boardburnerclub/LWP_LWD_robot/STL_files/boost_conv_assembly_prnt.3mf

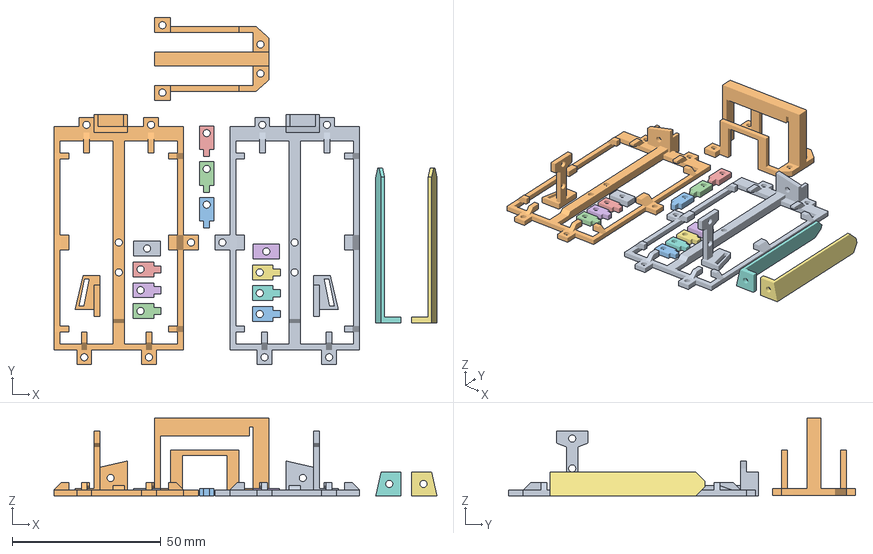
[picture p1: CAD file, 2025-04-11]
STL_files/boost_conv_assembly_prnt.3mf
128.5 x 116.6 x 26.1 mm
boost_conv_holder.stl x 2
boost_conv_holder_back_1.stl x 6
boost_conv_holder_back_2.stl x 3
boost_conv_holder_back_3.stl x 2
boost_conv_slide.stl x 2
boost_conv_slide_rec.stl x 2
BMS_Holder.stl
