boardburnerclub/LWP_LWD_robot/STL_files/LWP_39.stl

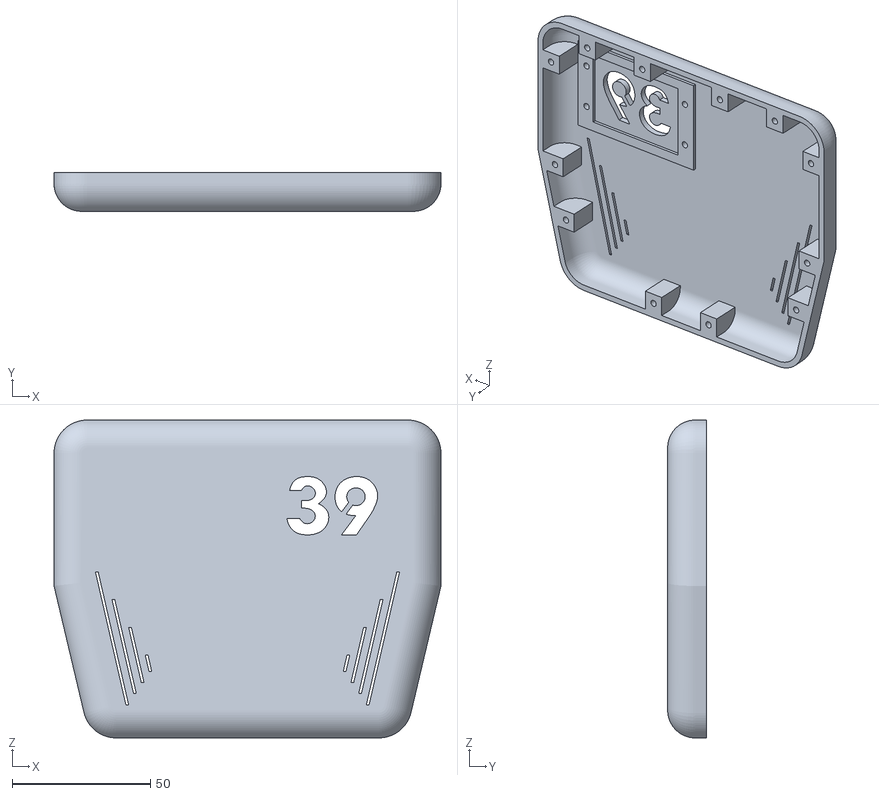
[picture p2: CAD file, 2025-05-03]
STL_files/LWP_39.stl
140.0 x 14.0 x 115.0
