boardburnerclub/LWP_LWD_robot/STL_files/foot_hip_shoulder_neck.3mf

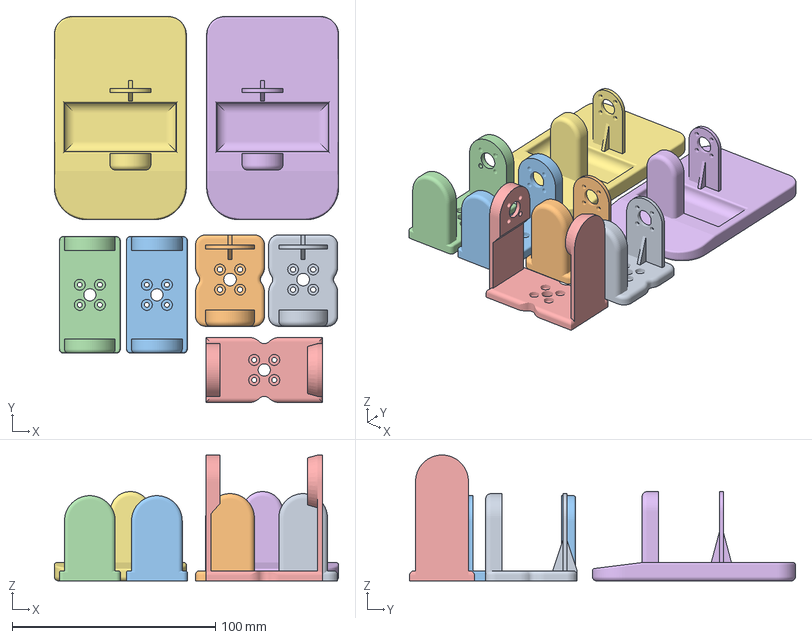
[picture p3: CAD file, 2025-04-19]
STL_files/foot_hip_shoulder_neck.3mf
140.0 x 190.0 x 62.0 mm
left_hip.stl x 2
left_shoulder.stl x 2
neck.stl
left_foot.stl x 2
