boardburnerclub/LWP_LWD_robot/STL_files/left_foot.stl

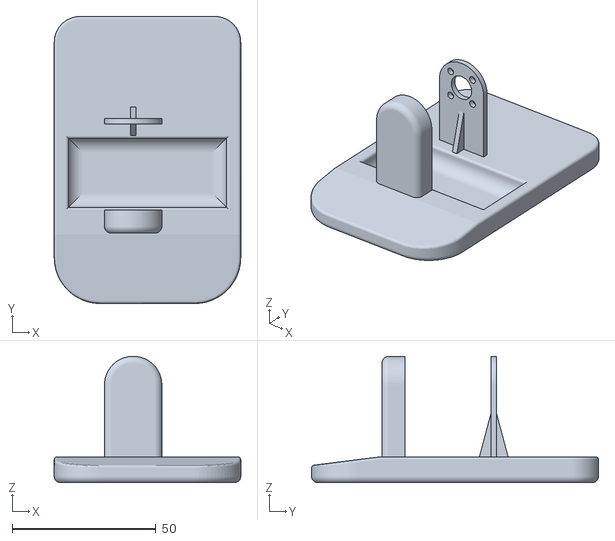
[picture p4: CAD file, 2025-04-19]
STL_files/left_foot.stl
65.0 x 100.0 x 44.0
