boardburnerclub/LWP_LWD_robot/STL_files/lower_leg.stl

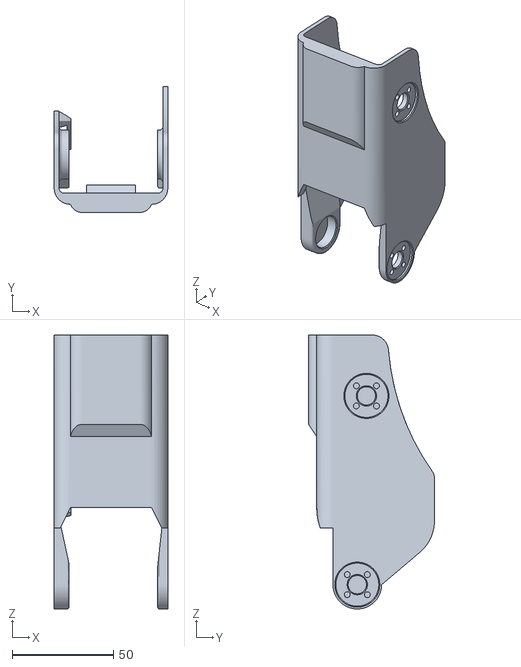
[picture p5: CAD file, 2025-04-12]
STL_files/lower_leg.stl
56.0 x 62.0 x 135.0
