boardburnerclub/LWP_LWD_robot/STL_files/left_upper_leg.stl

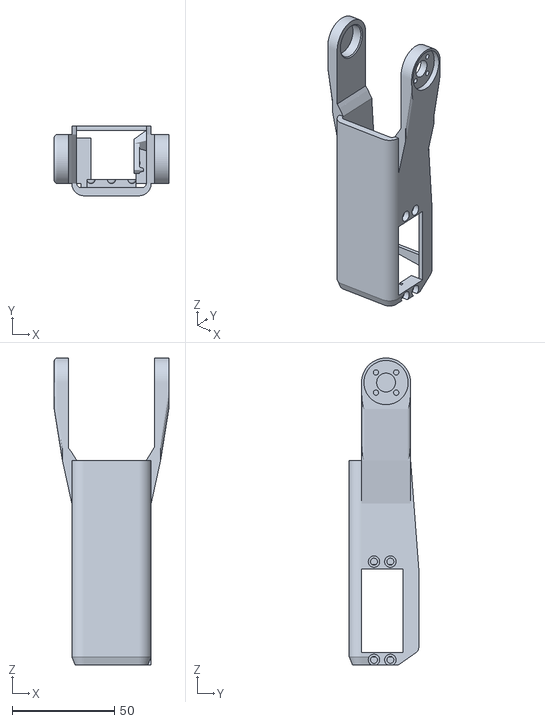
[picture p6: CAD file, 2025-04-12]
STL_files/left_upper_leg.stl
56.0 x 34.0 x 150.0
