boardburnerclub/LWP_LWD_robot/STL_files/legs_prnt.3mf

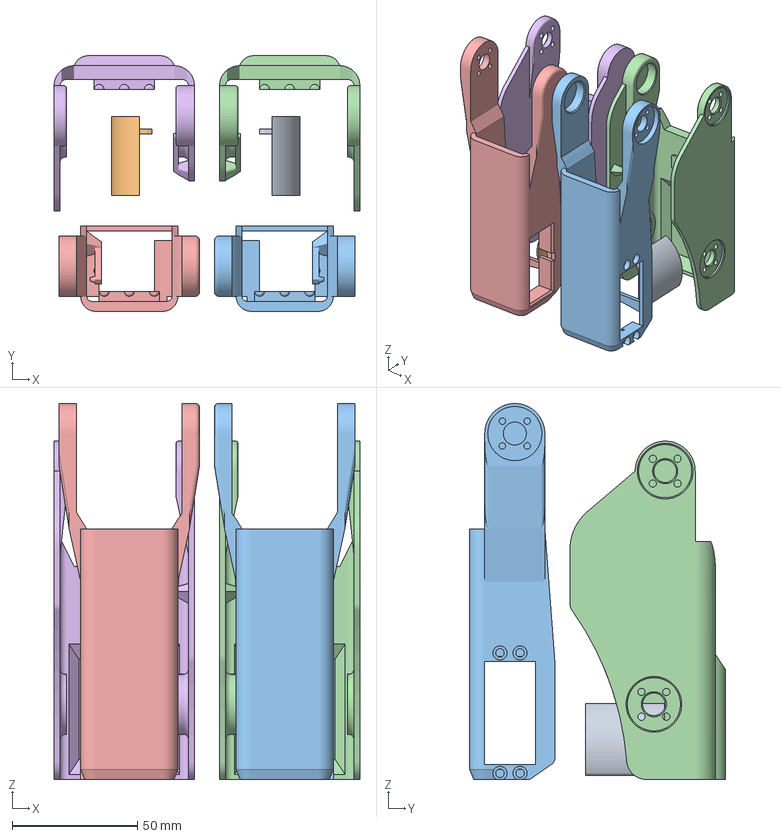
[picture p7: CAD file, 2025-04-12]
STL_files/legs_prnt.3mf
122.0 x 102.0 x 150.0 mm
left_knee_roller.stl x 2
left_upper_leg.stl x 2
lower_leg.stl x 2
