boardburnerclub/LWP_LWD_robot/STL_files/left_knee_roller.stl

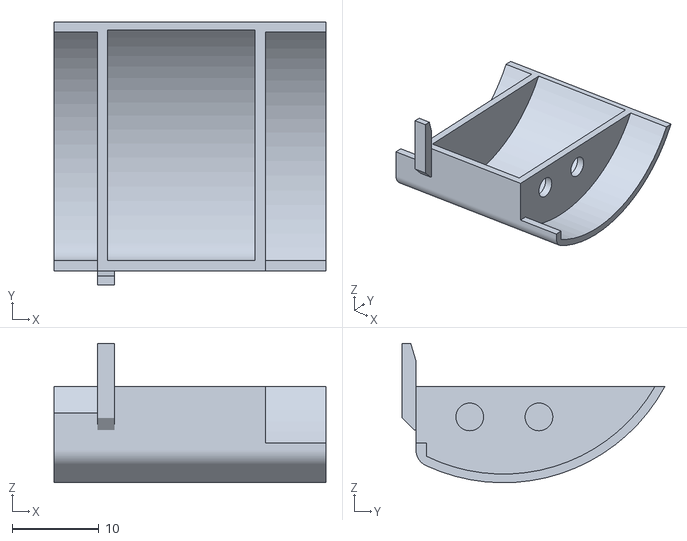
[picture p8: CAD file, 2025-04-11]
STL_files/left_knee_roller.stl
31.4 x 30.3 x 16.1
