boardburnerclub/LWP_LWD_robot/STL_files/head_led_wire_holder_downer.stl

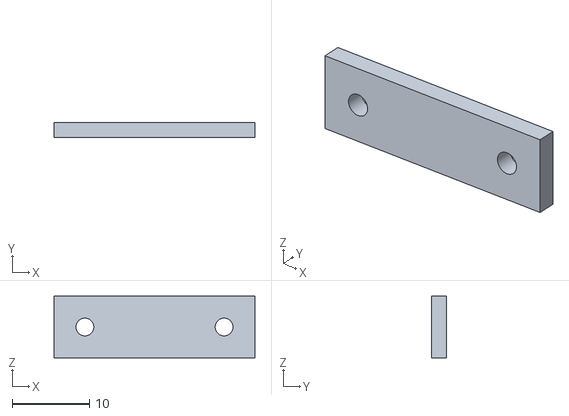
[picture p9: CAD file, 2025-04-11]
STL_files/head_led_wire_holder_downer.stl
26.0 x 2.00 x 8.00
