boardburnerclub/LWP_LWD_robot/STL_files/joint_spacer.stl

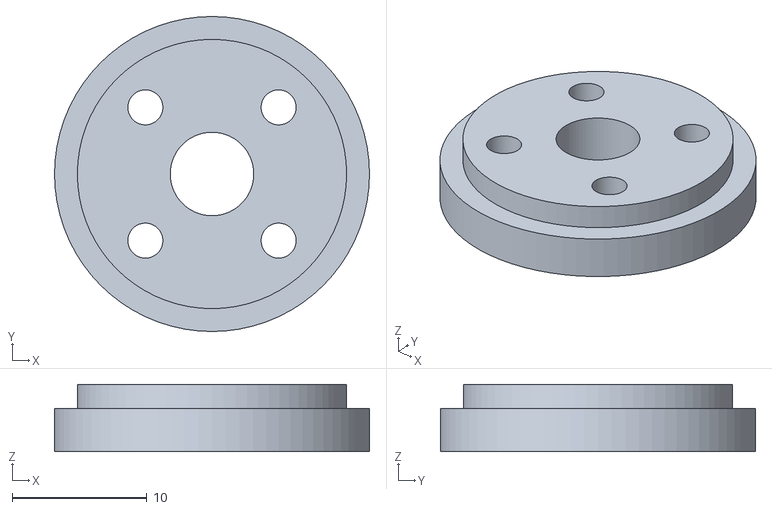
[picture p10: CAD file, 2025-04-11]
STL_files/joint_spacer.stl
23.4 x 23.4 x 5.00
