boardburnerclub/LWP_LWD_robot/STL_files/right_forearm.stl

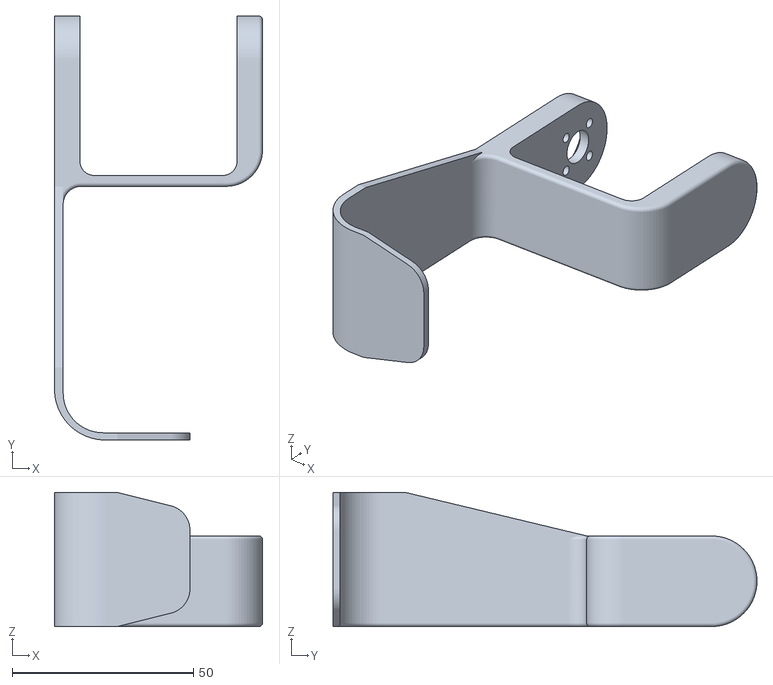
[picture p11: CAD file, 2025-04-11]
STL_files/right_forearm.stl
57.4 x 117.0 x 37.0
