boardburnerclub/LWP_LWD_robot/STL_files/battery_lid_insert.stl

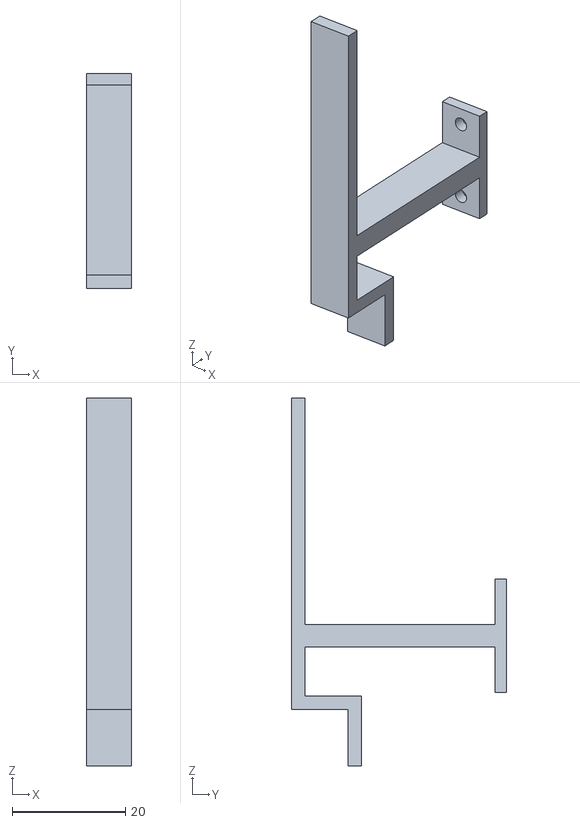
[picture p12: CAD file, 2025-04-11]
STL_files/battery_lid_insert.stl
8.00 x 38.0 x 65.0
