boardburnerclub/LWP_LWD_robot/STL_files/left_shoulder.stl

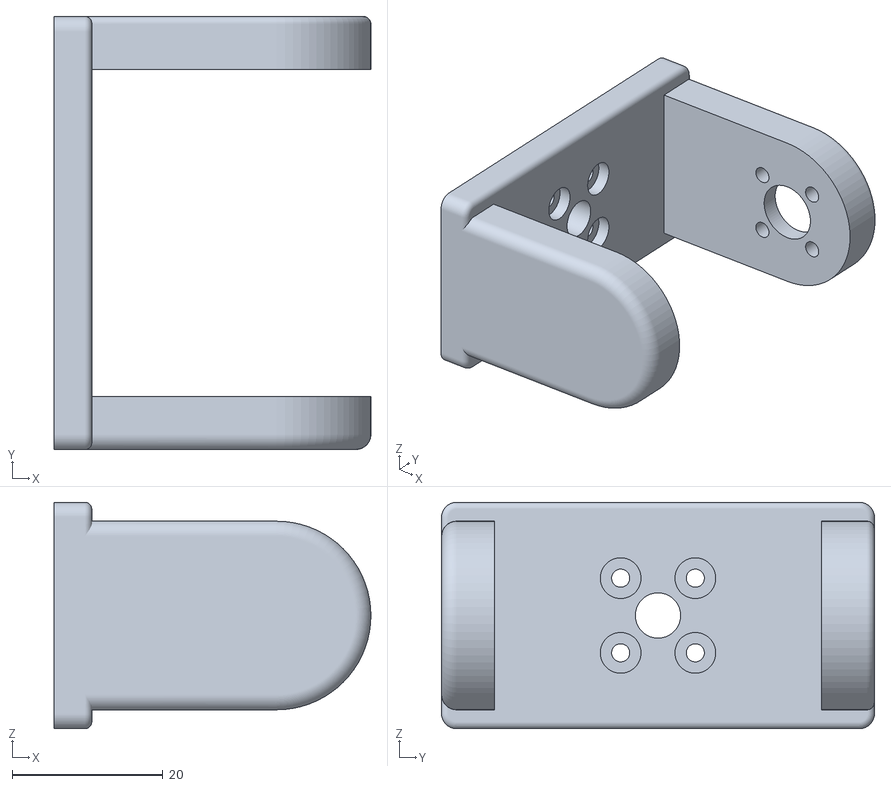
[picture p13: CAD file, 2025-04-11]
STL_files/left_shoulder.stl
42.0 x 57.4 x 30.0
