boardburnerclub/LWP_LWD_robot/STL_files/chest_back.stl

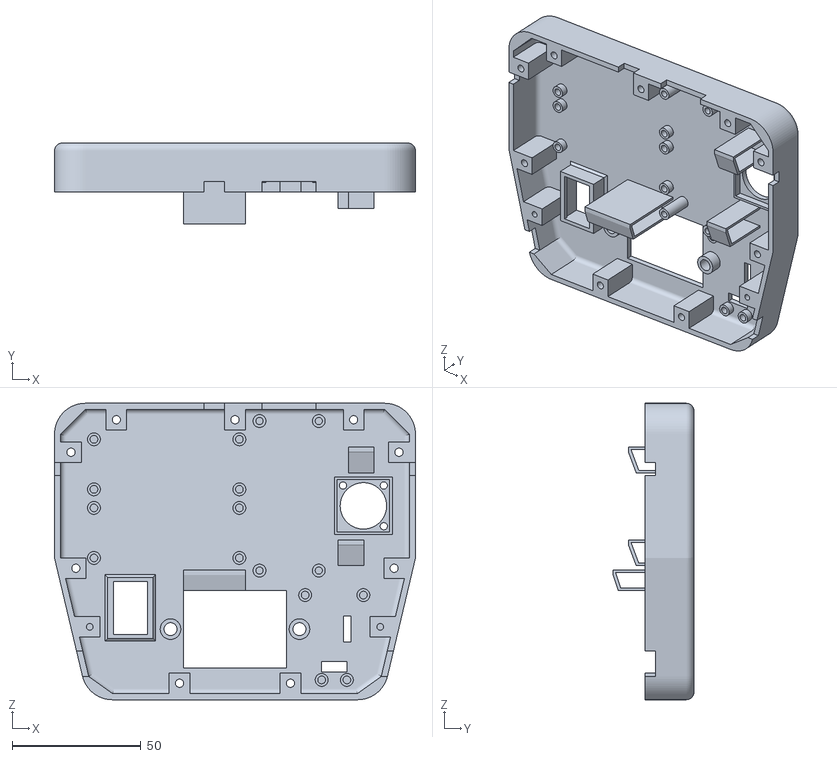
[picture p14: CAD file, 2025-04-11]
STL_files/chest_back.stl
140.0 x 31.4 x 115.0
