boardburnerclub/LWP_LWD_robot/STL_files/Chest_prnt.3mf

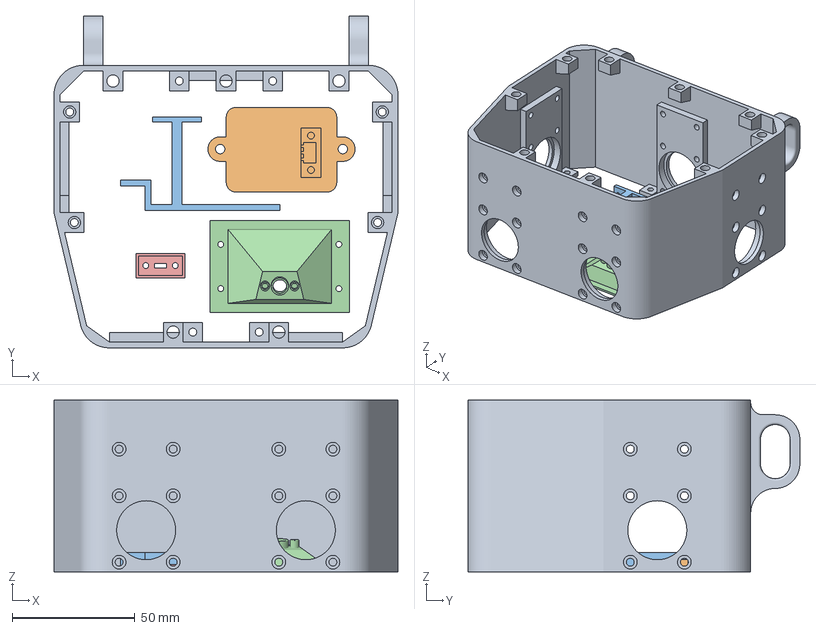
[picture p15: CAD file, 2025-04-11]
STL_files/Chest_prnt.3mf
140.0 x 135.0 x 70.0 mm
Chest.stl
battery_lid.stl
battery_lid_insert.stl
number_plate_holder.stl
number_plate_led_holder_downer.stl
