boardburnerclub/LWP_LWD_robot/STL_files/head_components_prnt.3mf

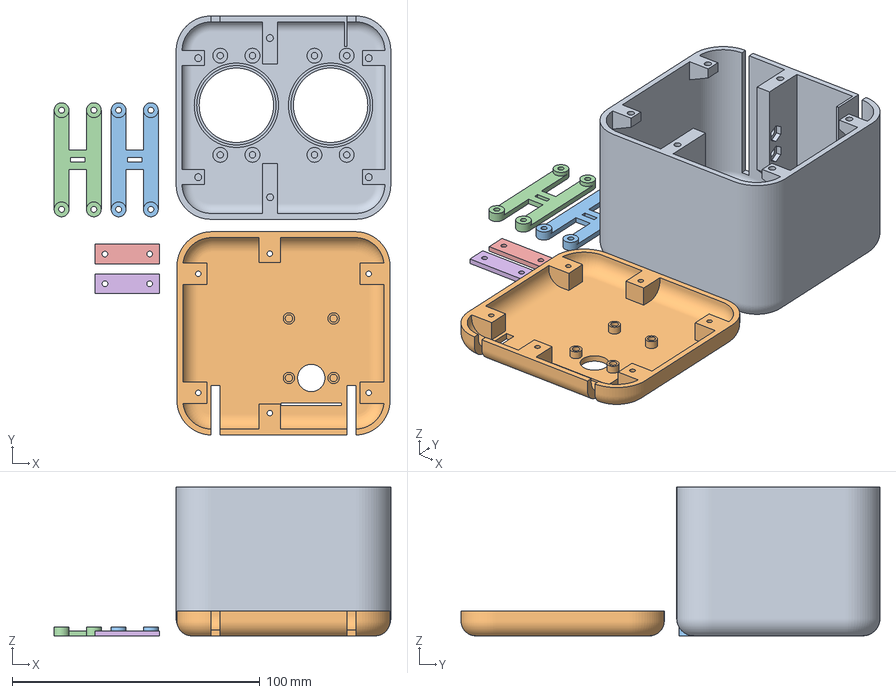
[picture p16: CAD file, 2025-04-11]
STL_files/head_components_prnt.3mf
135.8 x 169.0 x 60.0 mm
head.stl
head_back_cover.stl
eye_LED_holder.stl x 2
head_led_wire_holder_downer.stl x 2
