boardburnerclub/LWP_LWD_robot/STL_files/boost_conv_holder_back_3.stl

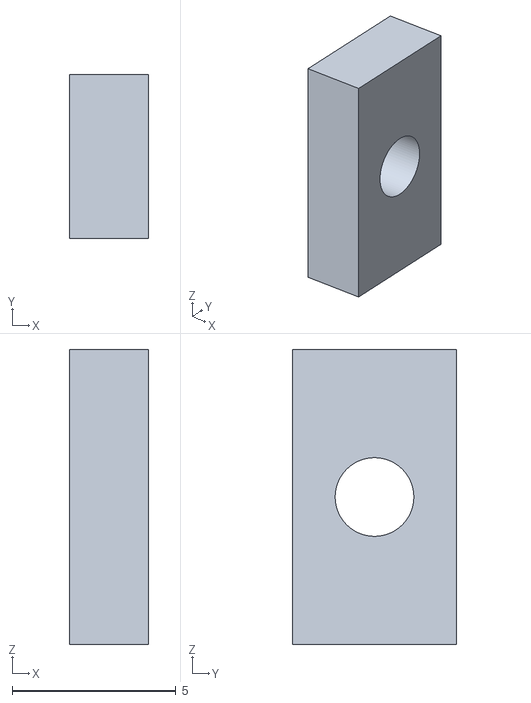
[picture p17: CAD file, 2025-04-11]
STL_files/boost_conv_holder_back_3.stl
2.40 x 5.00 x 9.00
