boardburnerclub/LWP_LWD_robot/STL_files/servo_holder_body.stl

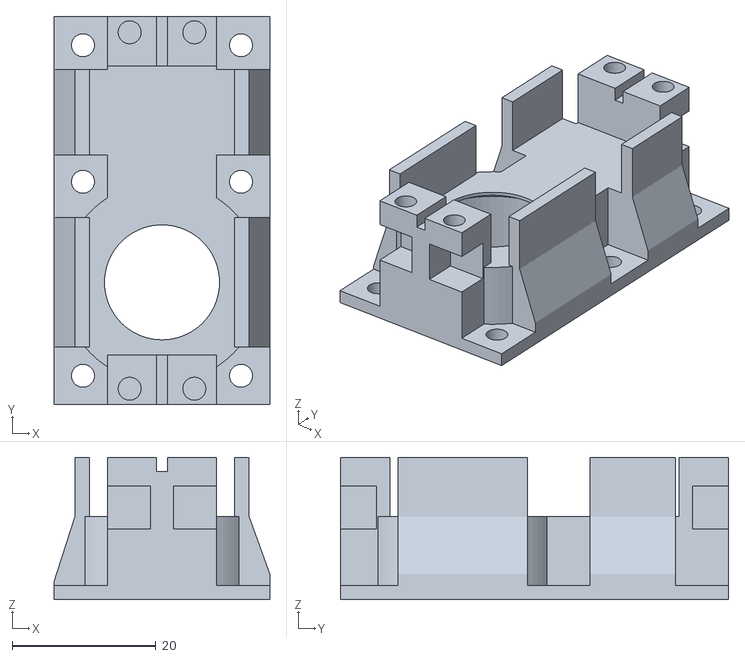
[picture p18: CAD file, 2025-04-11]
STL_files/servo_holder_body.stl
30.0 x 54.0 x 19.8
