boardburnerclub/LWP_LWD_robot/STL_files/number_plate_led_holder_downer.stl

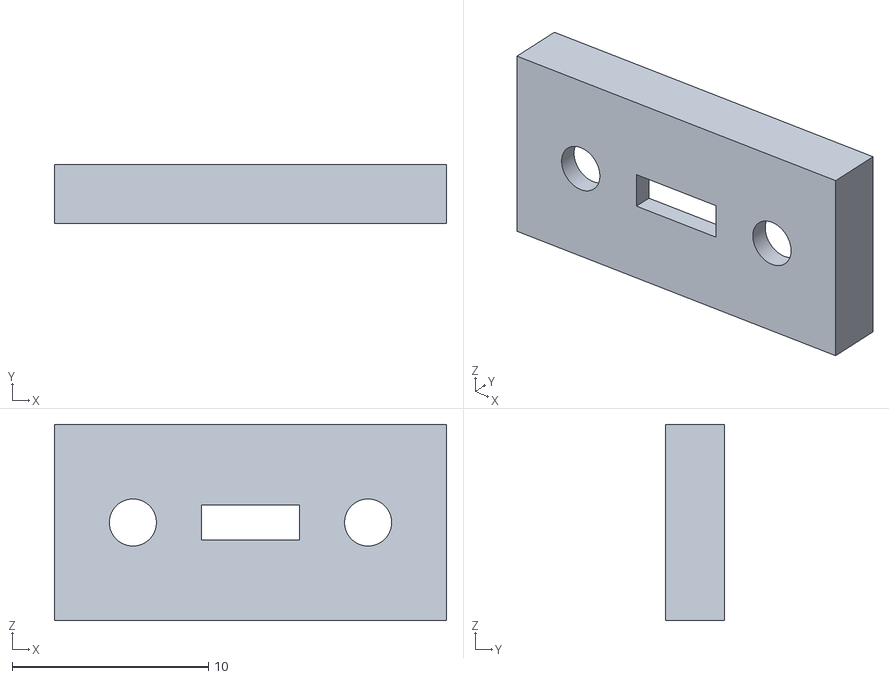
[picture p19: CAD file, 2025-04-11]
STL_files/number_plate_led_holder_downer.stl
20.0 x 3.00 x 10.0
