boardburnerclub/LWP_LWD_robot/STL_files/head.stl

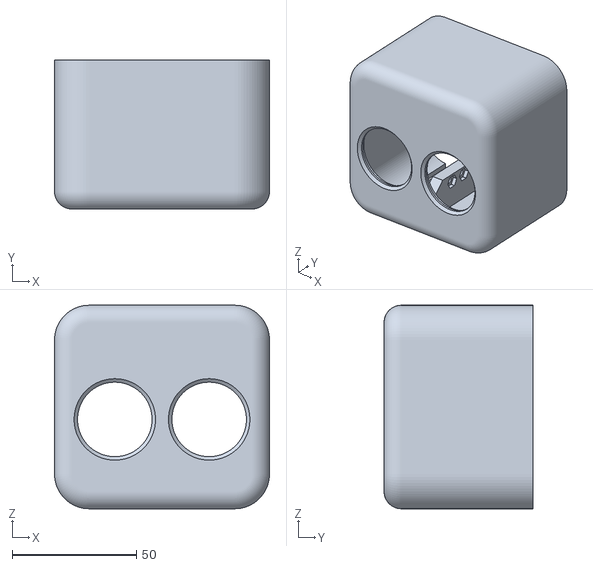
[picture p20: CAD file, 2025-04-11]
STL_files/head.stl
86.6 x 60.0 x 82.0
