boardburnerclub/LWP_LWD_robot/STL_files/iris_number_plate_back_prnt.3mf

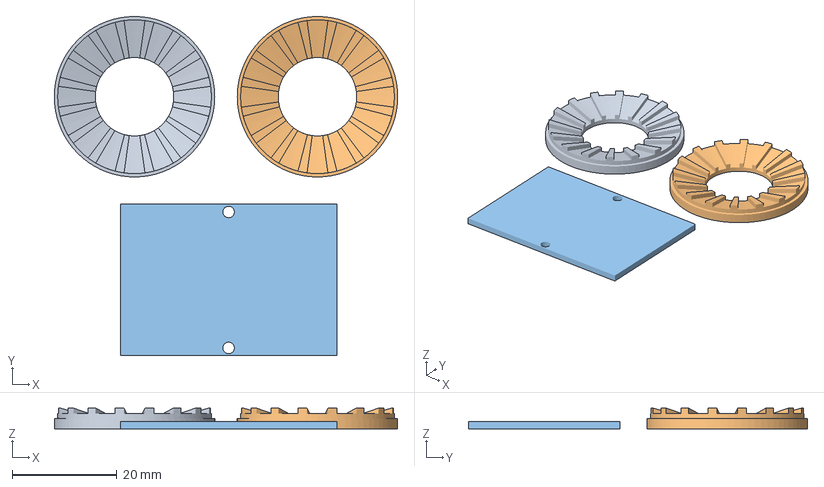
[picture p21: CAD file, 2025-04-11]
STL_files/iris_number_plate_back_prnt.3mf
65.7 x 64.9 x 4.00 mm
iris.stl x 2
chest_number_backing.stl
