boardburnerclub/LWP_LWD_robot/STL_files/boost_conv_holder.stl

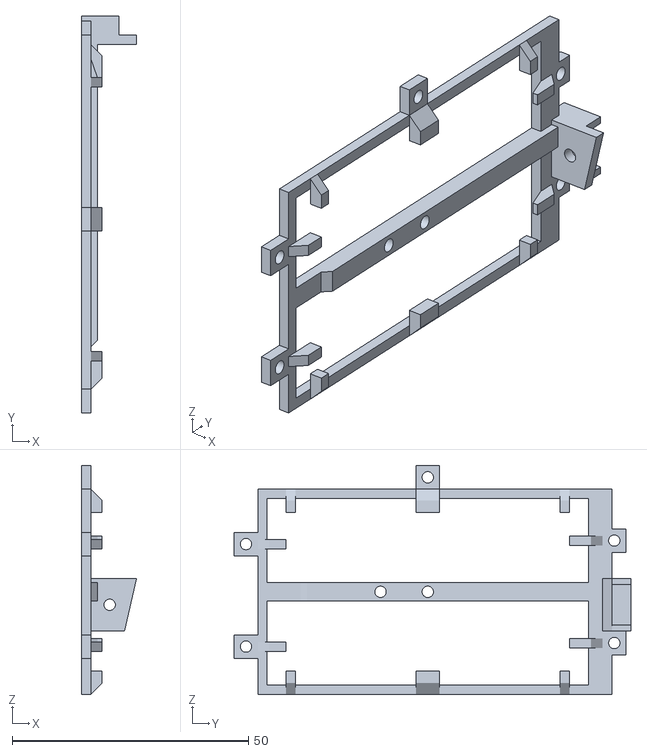
[picture p22: CAD file, 2025-04-11]
STL_files/boost_conv_holder.stl
11.7 x 84.0 x 48.5
