boardburnerclub/LWP_LWD_robot/STL_files/chest_number_backing.stl

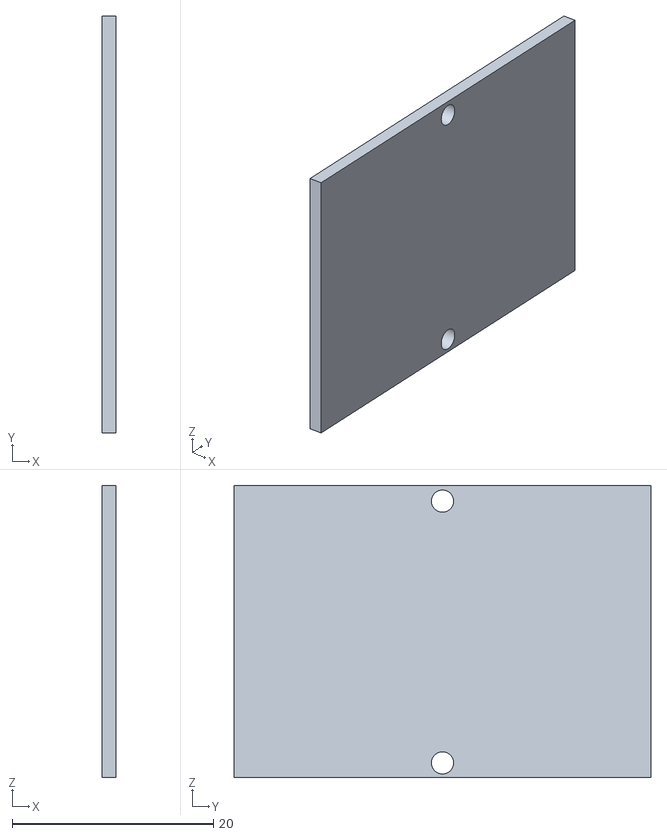
[picture p23: CAD file, 2025-04-11]
STL_files/chest_number_backing.stl
1.40 x 41.4 x 29.0
