boardburnerclub/LWP_LWD_robot/STL_files/left_hip.stl

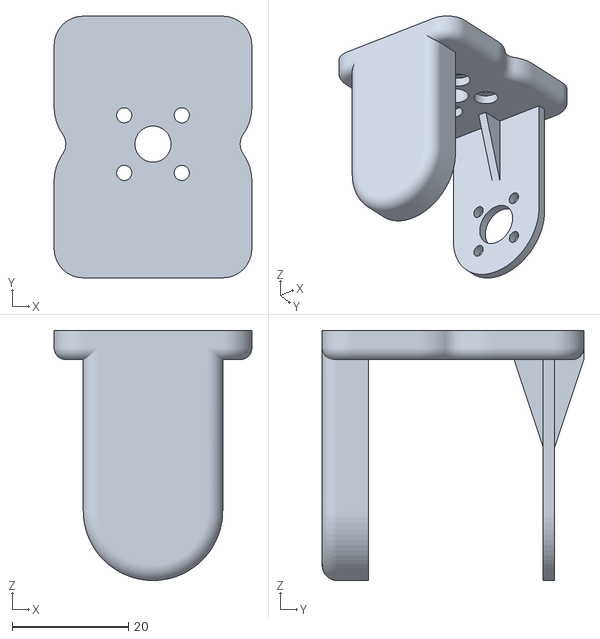
[picture p24: CAD file, 2025-04-11]
STL_files/left_hip.stl
34.0 x 45.0 x 43.0
