boardburnerclub/LWP_LWD_robot/STL_files/servo_back.stl

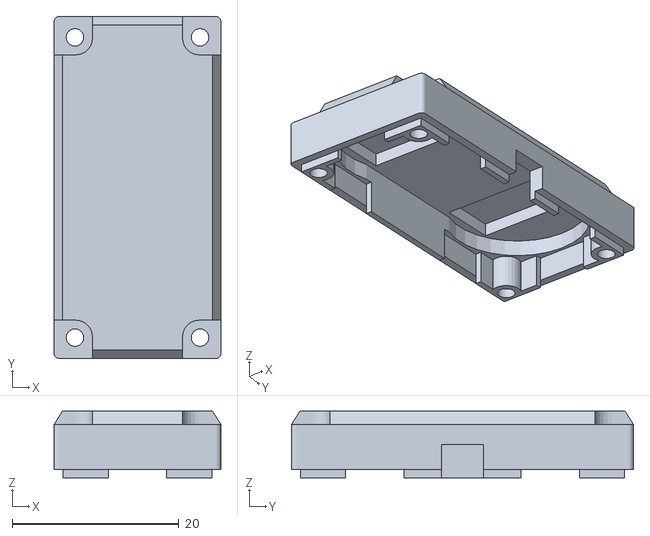
[picture p25: CAD file, 2025-04-11]
STL_files/servo_back.stl
20.0 x 41.0 x 8.00
