boardburnerclub/LWP_LWD_robot/STL_files/BMS_Holder.stl

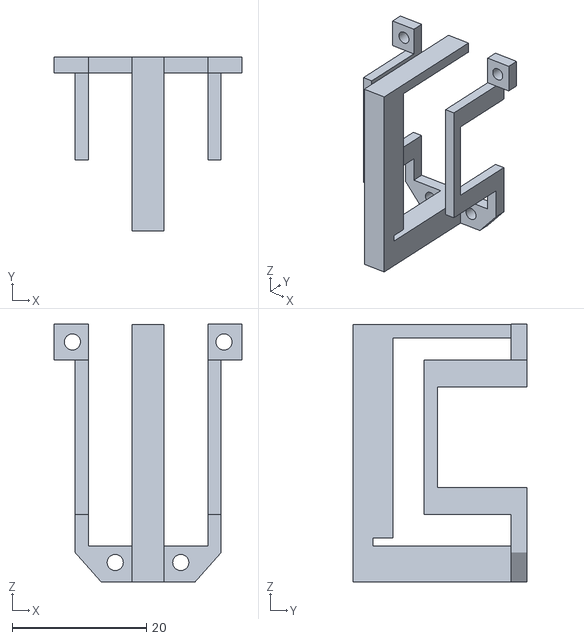
[picture p26: CAD file, 2025-04-11]
STL_files/BMS_Holder.stl
28.0 x 26.0 x 38.5
