boardburnerclub/LWP_LWD_robot/STL_files/eye_LED.stl

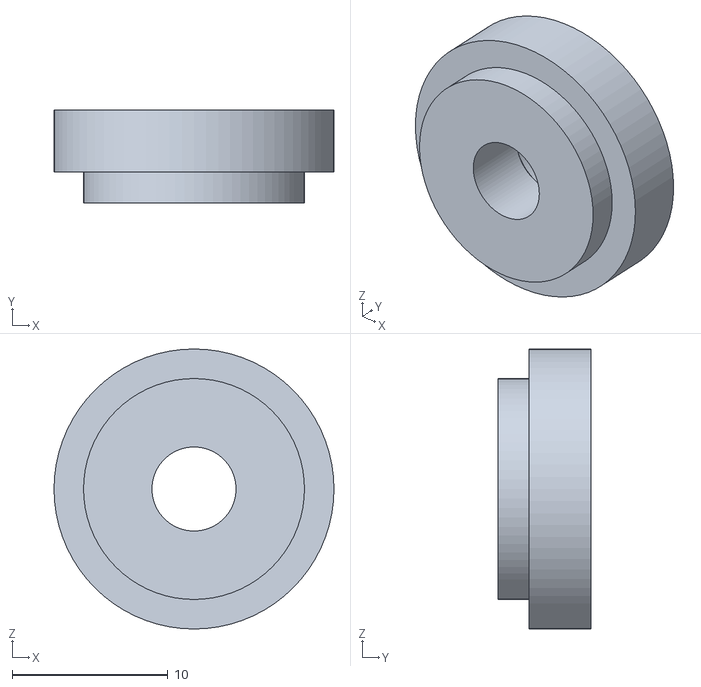
[picture p27: CAD file, 2025-04-11]
STL_files/eye_LED.stl
18.0 x 6.00 x 18.0
