boardburnerclub/LWP_LWD_robot/STL_files/servo_back_axle_R.stl

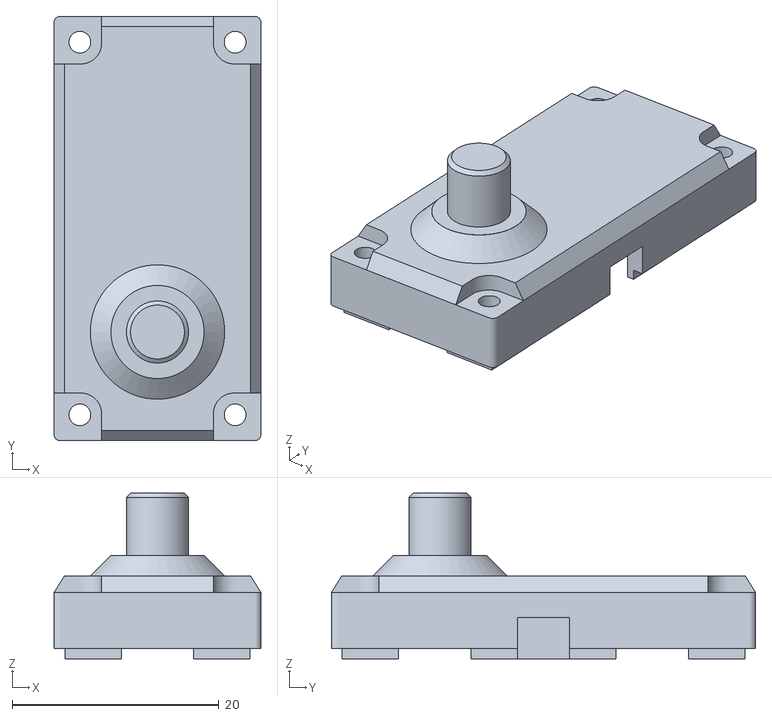
[picture p28: CAD file, 2025-04-11]
STL_files/servo_back_axle_R.stl
20.0 x 41.0 x 16.0
