boardburnerclub/LWP_LWD_robot/STL_files/Chest.stl

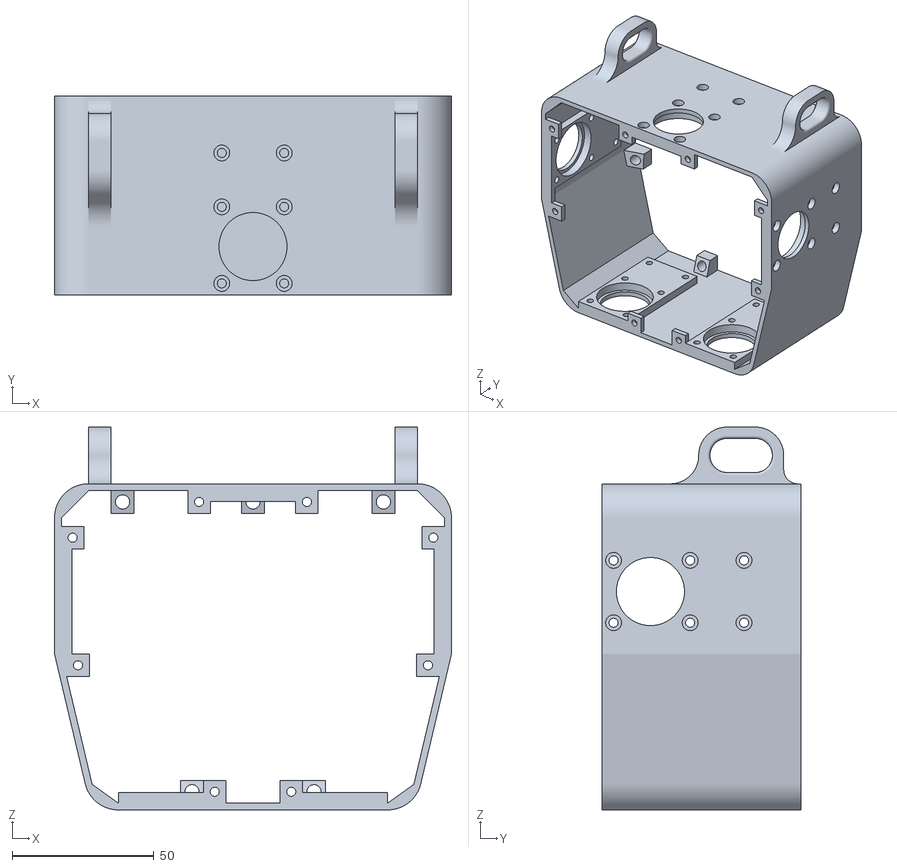
[picture p29: CAD file, 2025-04-11]
STL_files/Chest.stl
140.0 x 70.0 x 135.0
