boardburnerclub/LWP_LWD_robot/STL_files/servo_back_prnt.3mf

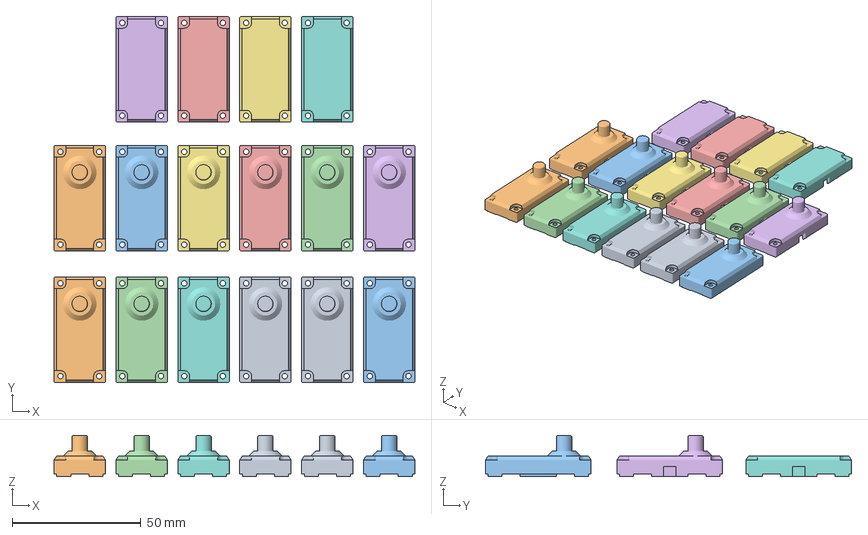
[picture p30: CAD file, 2025-04-11]
STL_files/servo_back_prnt.3mf
140.0 x 142.0 x 16.0 mm
servo_back_axle_R.stl x 6
servo_back_axle_L.stl x 6
servo_back.stl x 4
