boardburnerclub/LWP_LWD_robot/STL_files/number_plate_holder.stl

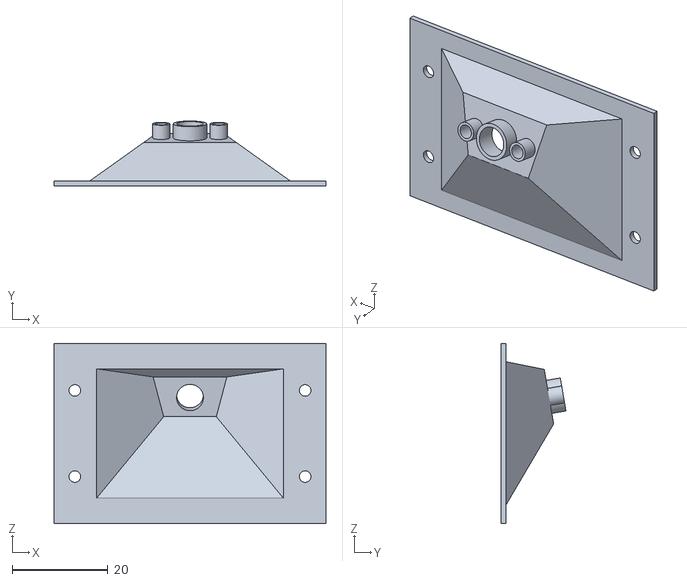
[picture p31: CAD file, 2025-04-11]
STL_files/number_plate_holder.stl
56.8 x 13.6 x 37.6
