boardburnerclub/LWP_LWD_robot/STL_files/head_back_cover.stl

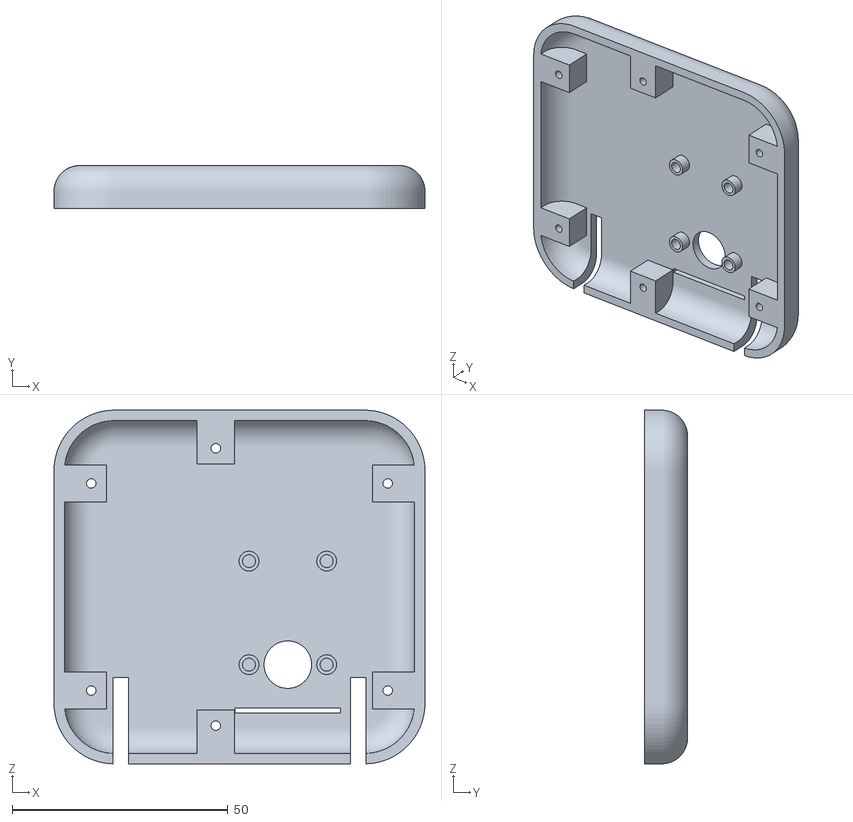
[picture p32: CAD file, 2025-04-11]
STL_files/head_back_cover.stl
86.0 x 10.0 x 82.0
