boardburnerclub/LWP_LWD_robot/STL_files/eye_LED_holder.stl

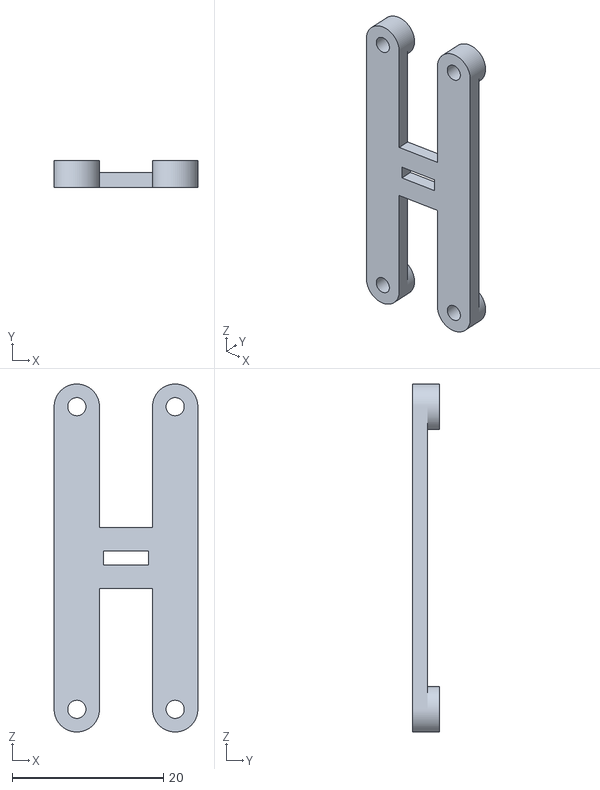
[picture p33: CAD file, 2025-04-11]
STL_files/eye_LED_holder.stl
19.0 x 3.60 x 46.0
