boardburnerclub/LWP_LWD_robot/STL_files/boost_conv_slide.stl

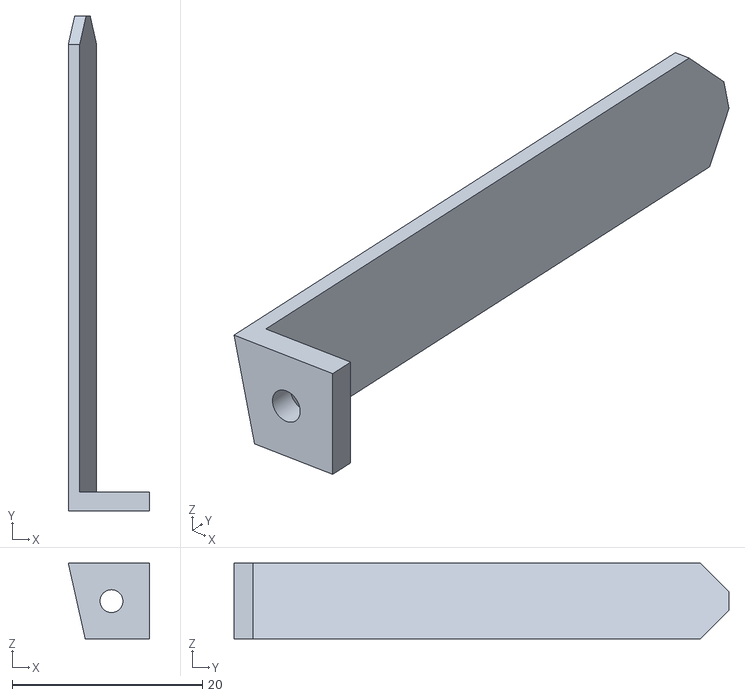
[picture p34: CAD file, 2025-04-11]
STL_files/boost_conv_slide.stl
8.56 x 52.0 x 7.95
