boardburnerclub/LWP_LWD_robot/STL_files/boost_conv_slide_rec.stl

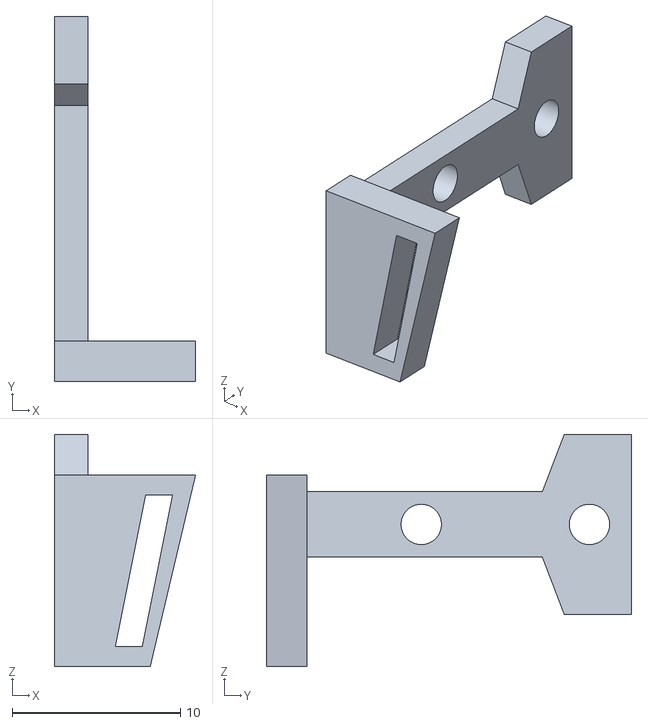
[picture p35: CAD file, 2025-04-11]
STL_files/boost_conv_slide_rec.stl
8.40 x 21.7 x 13.8
