boardburnerclub/LWP_LWD_robot/STL_files/two_servo_holder.stl

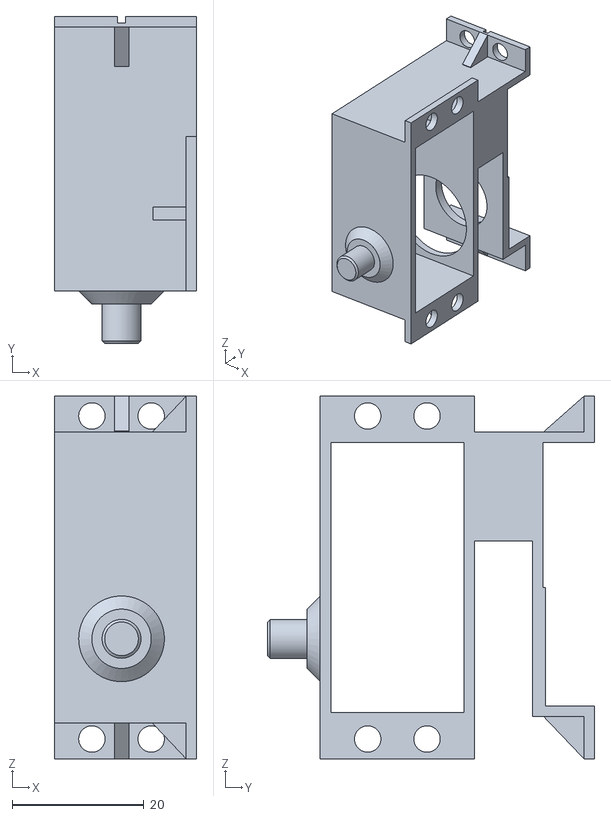
[picture p36: CAD file, 2025-04-11]
STL_files/two_servo_holder.stl
21.6 x 49.6 x 55.0
