boardburnerclub/LWP_LWD_robot/STL_files/iris.stl

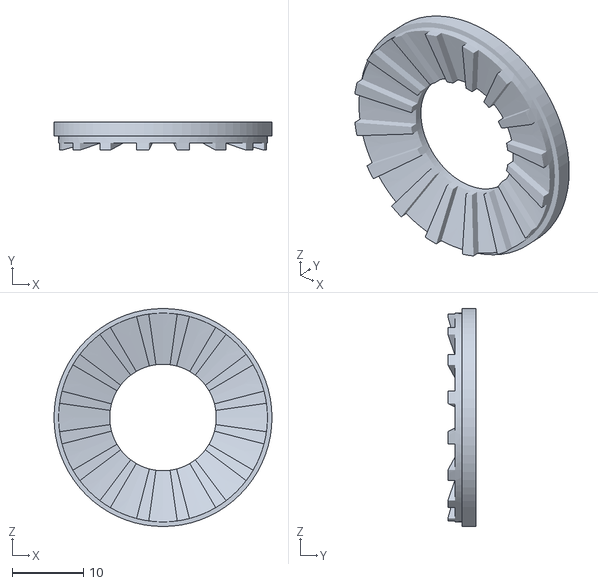
[picture p37: CAD file, 2025-04-11]
STL_files/iris.stl
30.7 x 4.00 x 30.7
