boardburnerclub/LWP_LWD_robot/STL_files/eye_led_prnt.3mf

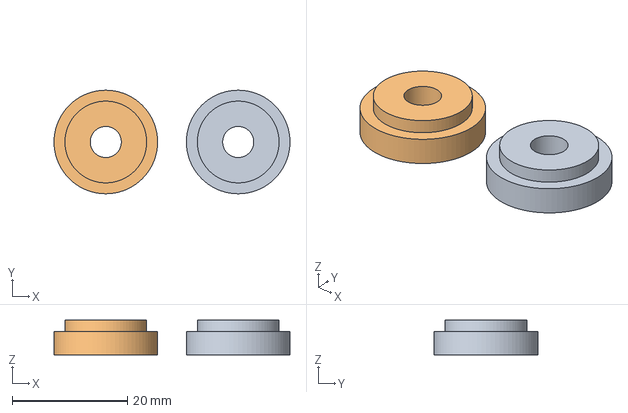
[picture p38: CAD file, 2025-04-11]
STL_files/eye_led_prnt.3mf
41.0 x 18.0 x 6.00 mm
eye_LED.stl x 2
