boardburnerclub/LWP_LWD_robot/STL_files/neck.stl

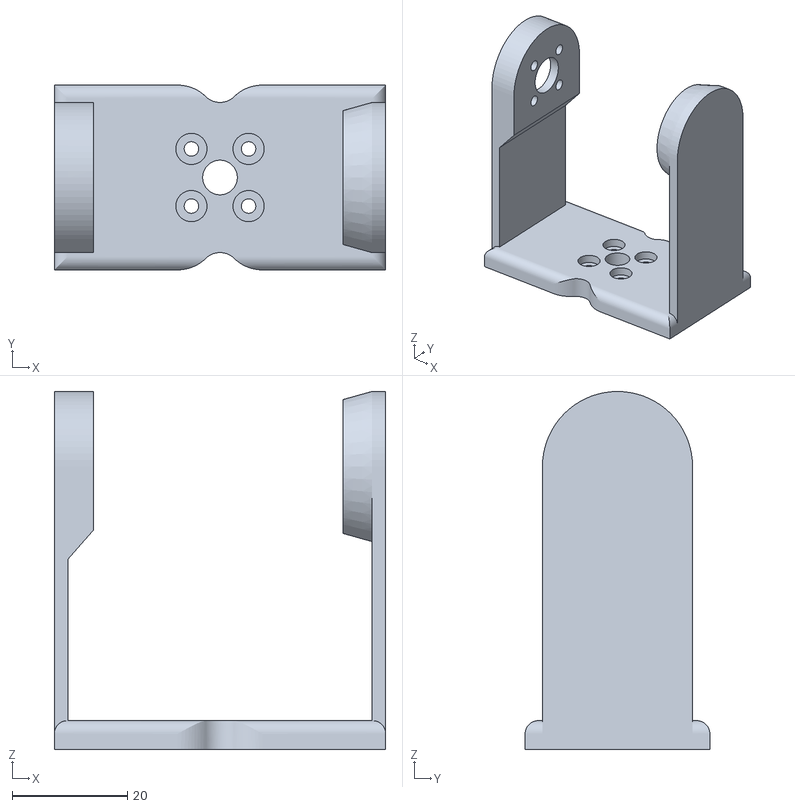
[picture p39: CAD file, 2025-04-11]
STL_files/neck.stl
57.4 x 32.0 x 62.0
