boardburnerclub/LWP_LWD_robot/STL_files/boost_conv_holder_back_2.stl

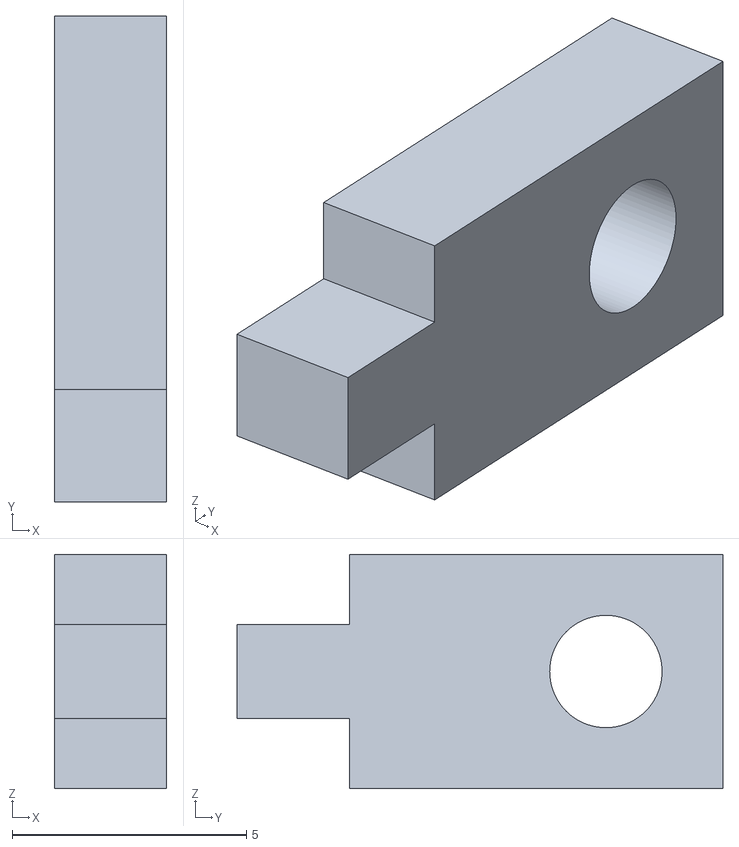
[picture p40: CAD file, 2025-04-11]
STL_files/boost_conv_holder_back_2.stl
2.40 x 10.4 x 5.00
