boardburnerclub/LWP_LWD_robot/STL_files/left_upper_arm.stl

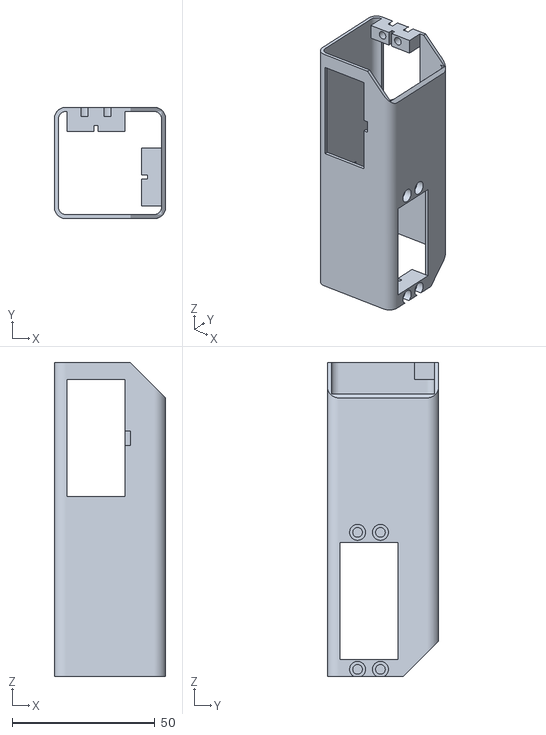
[picture p41: CAD file, 2025-04-11]
STL_files/left_upper_arm.stl
39.0 x 39.0 x 110.0
