boardburnerclub/LWP_LWD_robot/STL_files/boost_conv_holder_back_1.stl

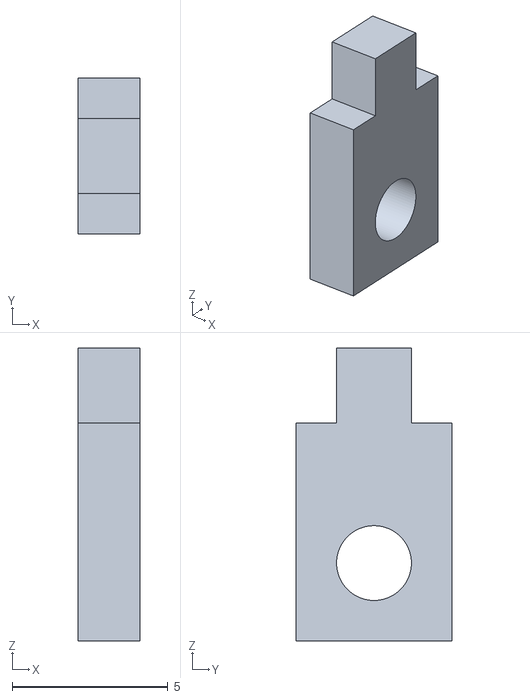
[picture p42: CAD file, 2025-04-11]
STL_files/boost_conv_holder_back_1.stl
2.00 x 5.00 x 9.40
