boardburnerclub/LWP_LWD_robot/STL_files/battery_lid.stl

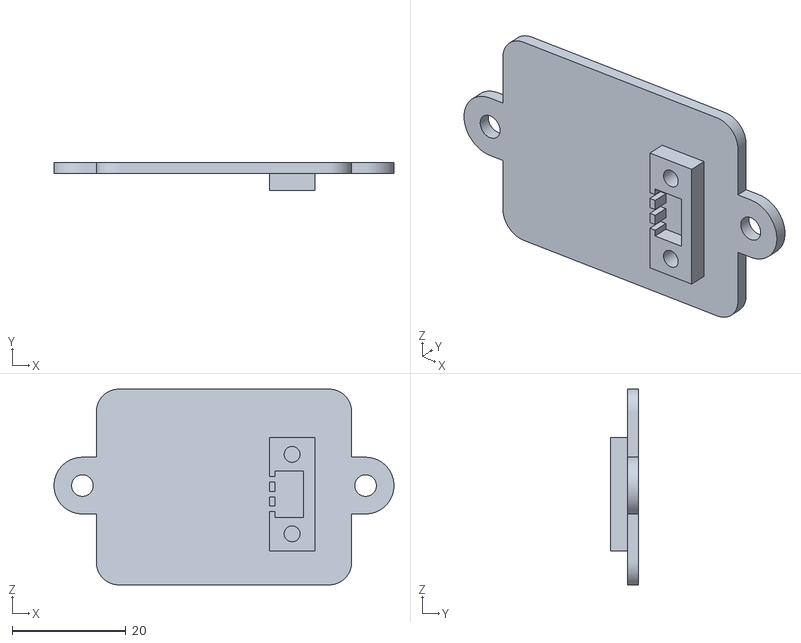
[picture p43: CAD file, 2025-04-11]
STL_files/battery_lid.stl
59.9 x 5.00 x 34.5
