boardburnerclub/LWP_LWD_robot/STL_files/arms_prnt.3mf

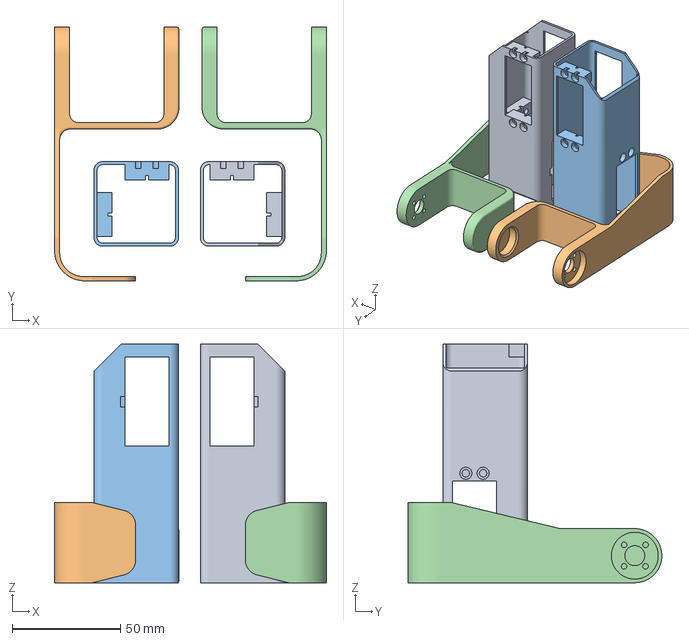
[picture p44: CAD file, 2025-04-11]
STL_files/arms_prnt.3mf
125.4 x 117.0 x 110.0 mm
left_upper_arm.stl x 2
right_forearm.stl x 2
