boardburnerclub/LWP_LWD_robot/(list of files, cad)

Other CAD files:
STL_files/LWP_71.stl
STL_files/LWP_minus_1.stl
STL_files/Chest_back_prnt.3mf
STL_files/servo_back_axle_L.stl
