boardburnerclub/LWP_LWD_robot/build_instructions/LWP chest plate build instructions.pdf

LWP chest plate build instructions

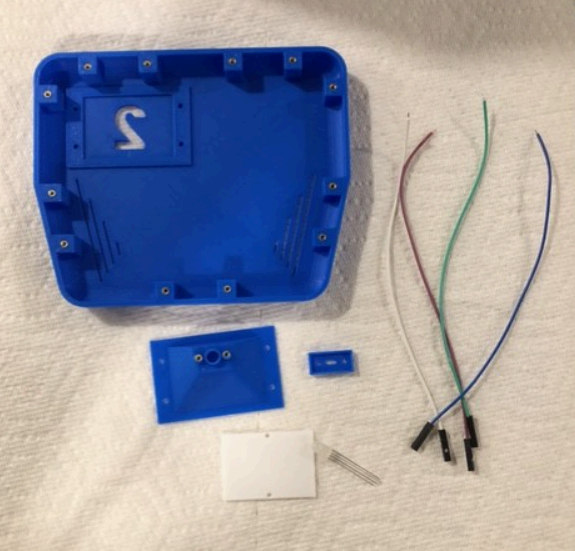
[picture p69: figure]

Chest plate, while piece, led, led wires, led holder and led holder downer.

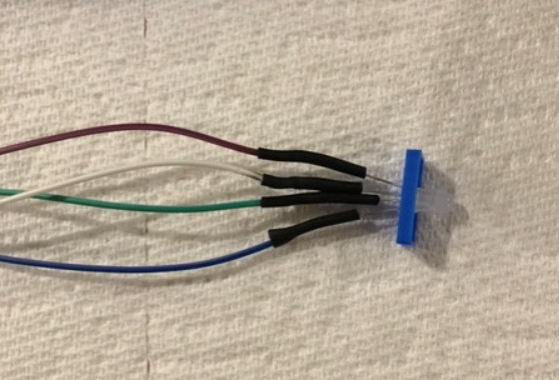
[picture p70: figure]

Solder and heat shrink wires to led leads. Longest lead is ground.

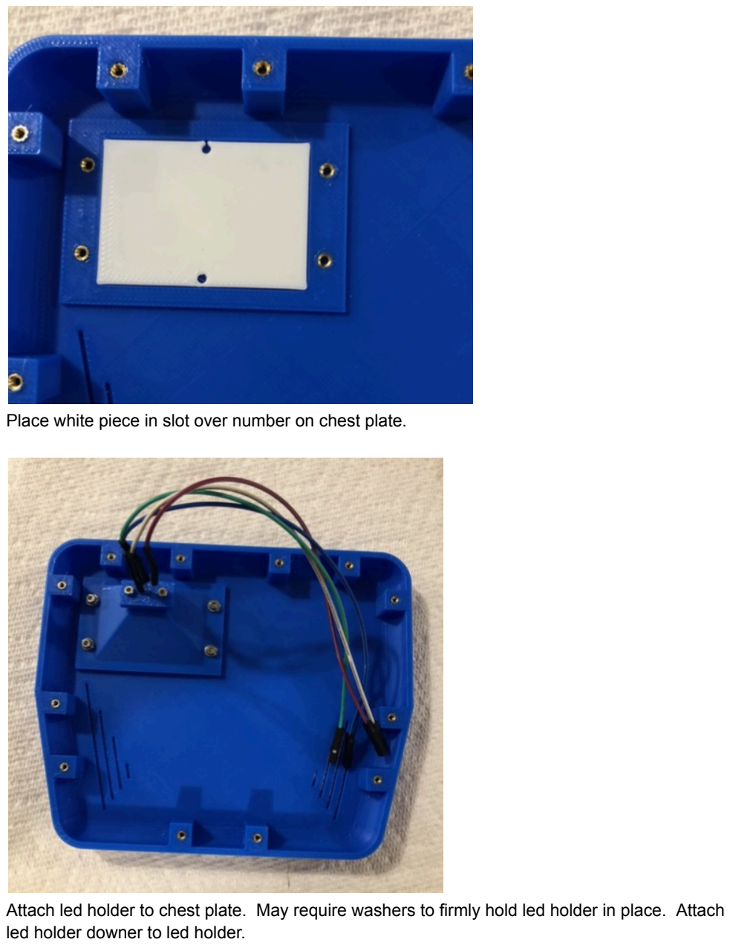
[picture p71: page 2]

Place white piece in slot over number on chest plate.

Attach led holder to chest plate. May require washers to firmly hold led holder in place. Attach led holder downer to led holder.
