boardburnerclub/LWP_LWD_robot/build_instructions/LWP heat set insert build instructions.pdf

LWP heat set insert build instructions

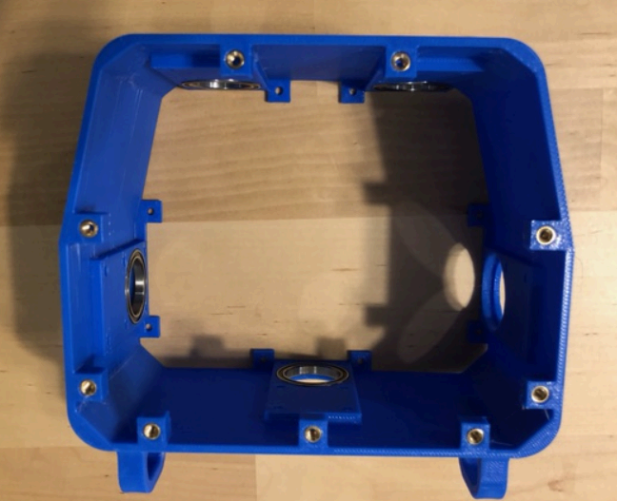
[picture p72: figure]

M3 heat set inserts for chest.

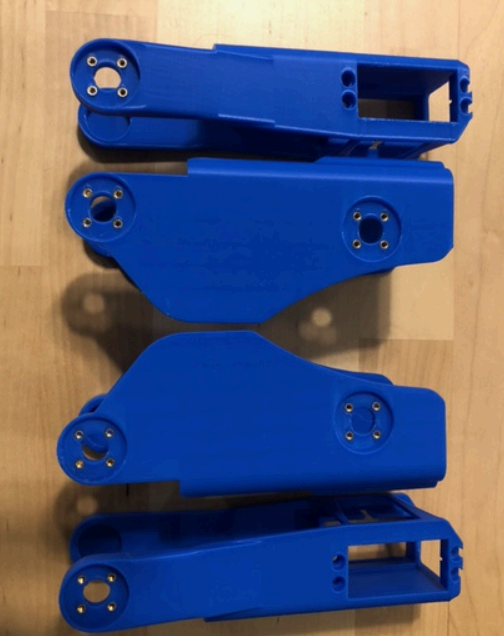
[picture p73: figure]

M2 heat sets for the legs.

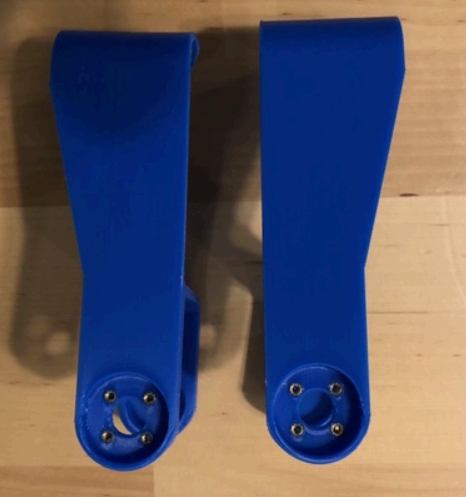
[picture p74: figure]

M2 heat sets for the arms.

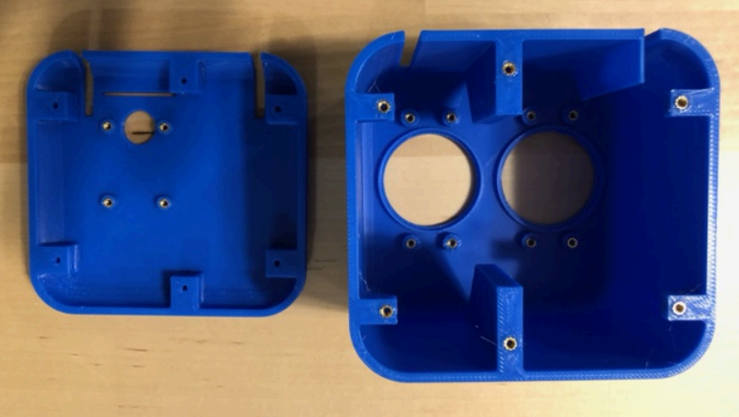
[picture p75: figure]

M2 heat sets for the head.

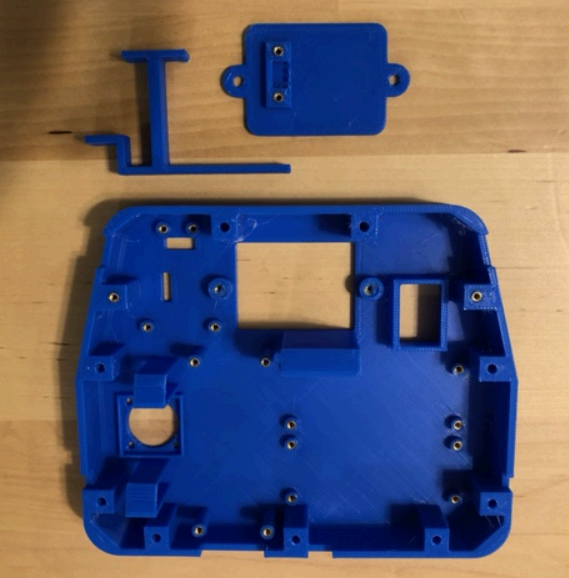
[picture p76: figure]

M2 heat sets for the back plat internals. M3 heat set to be inserted from the back side for the battery cover.

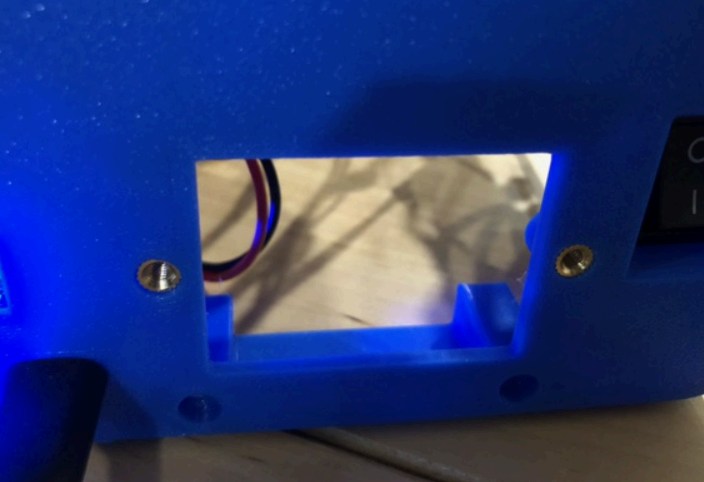
[picture p77: figure]

M3 heat set inserts for the back of the back plate.

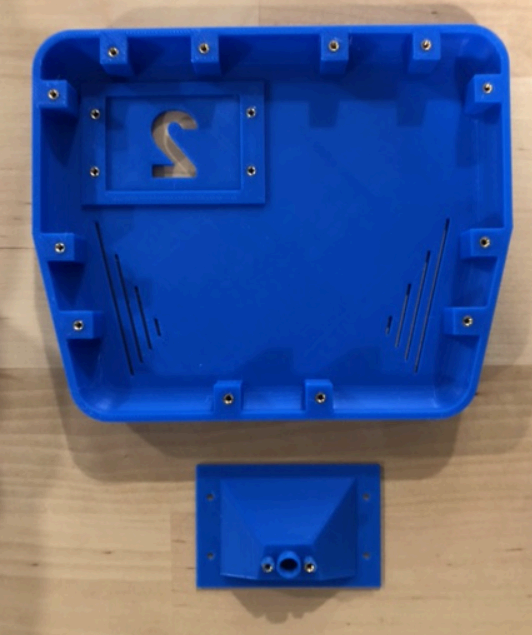
[picture p78: figure]

M2 heat sets for the chest pieces.

Not pictured: shoulders and neck. All require four M2 heat set inserts
