boardburnerclub/LWP_LWD_robot/build_instructions/LWP Back Plate Build Instructions pt 1.pdf

LWP Back Plate Build Instructions

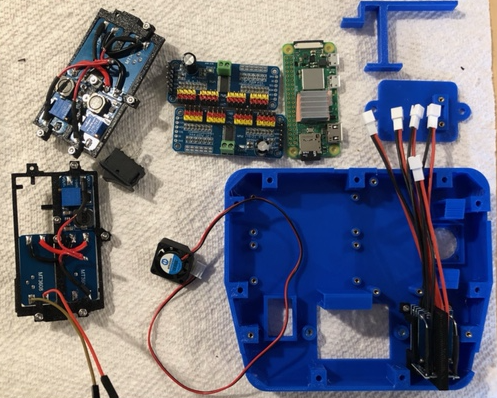
[picture p79: figure]

Back plate, BMS module, two boost converter assemblies, two PCA boards, one raspberry pi zero 2W, small fan, and battery back plate.

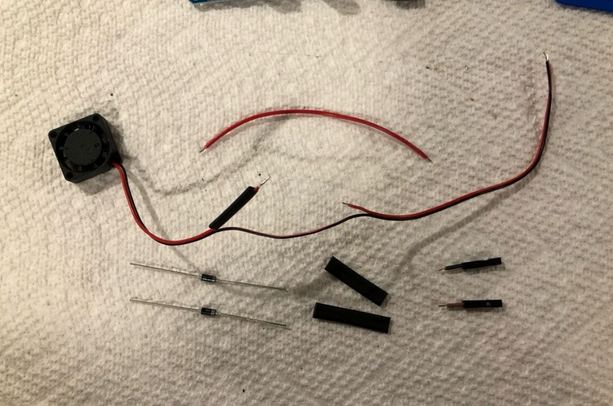
[picture p80: figure]

To use the fan we need to sever the red wire and attach two diodes to the end closest to the fan. Both diodes pointing to the fan (silver end indicates direction of current). Note we have
removed the fan connector. We will install jumper pin connectors in their place. The purpose of this is so that the fan will be powered on while the robot is in operation and it will also power on when the robot is connected to a power cable.

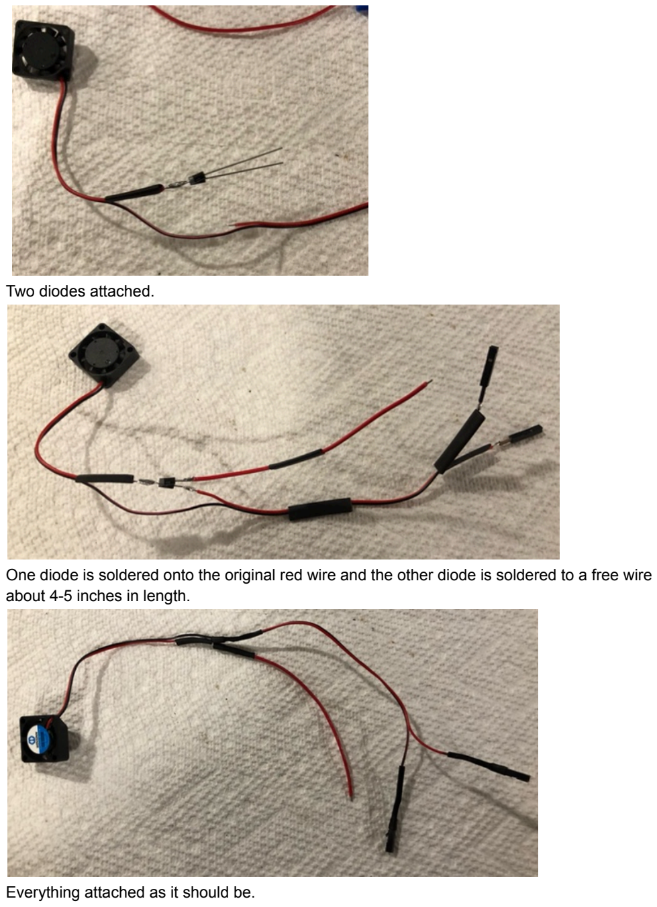
[picture p81: page 2]

Two diodes attached.

One diode is soldered onto the original red wire and the other diode is soldered to a free wire about 4-5 inches in length.

Everything attached as it should be.

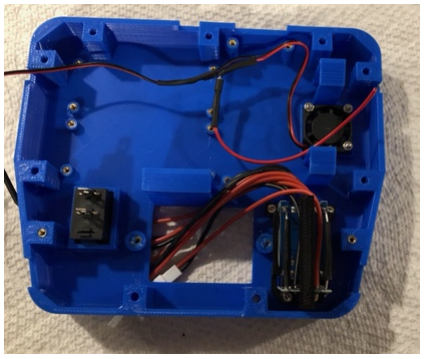
[picture p82: figure]

You may now install the fan in the back plate.

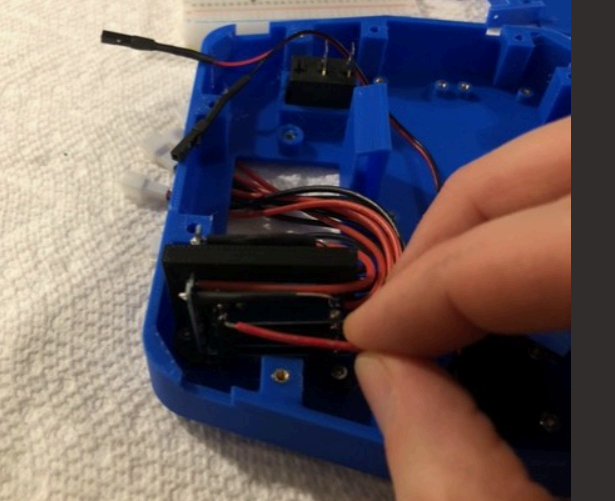
[picture p83: figure]

Attach the free red wire to the USB power rail. This is the small wire we left at a slightly longer length in the BMS module.

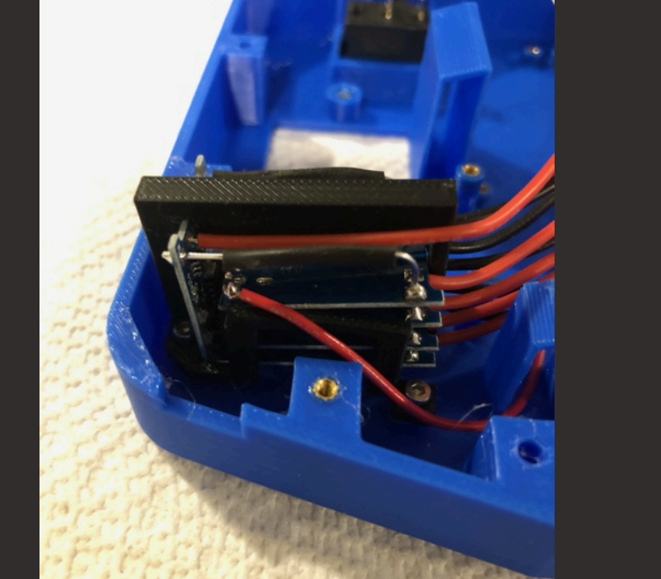
[picture p84: figure]

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
d. N

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
el. T

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
n in

s

t

all p

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
